SkCubeSat/SNN-Adapter/ethernet-breakout/pcb/footprint_3d/TMJG4820GENL.stp

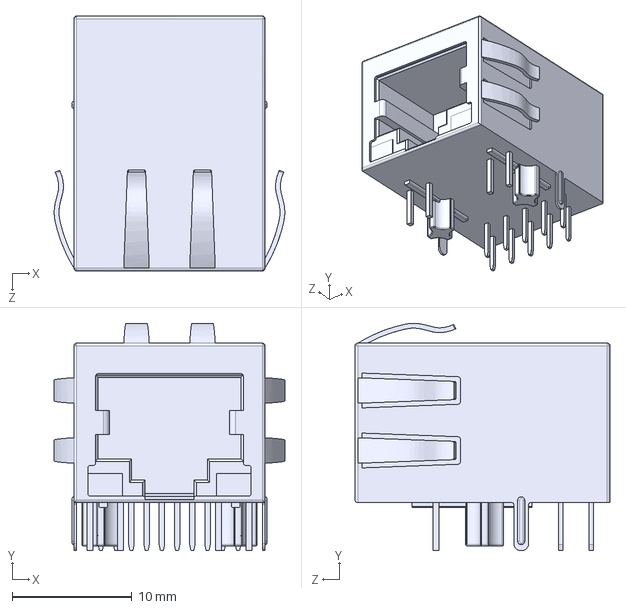
[picture p1: CAD file, 2026-05-10]
ethernet-breakout/pcb/footprint_3d/TMJG4820GENL.stp
19.2 x 18.9 x 21.2 mm
