SkCubeSat/SNN-Adapter/footprint_3d/RTW0024B.stp

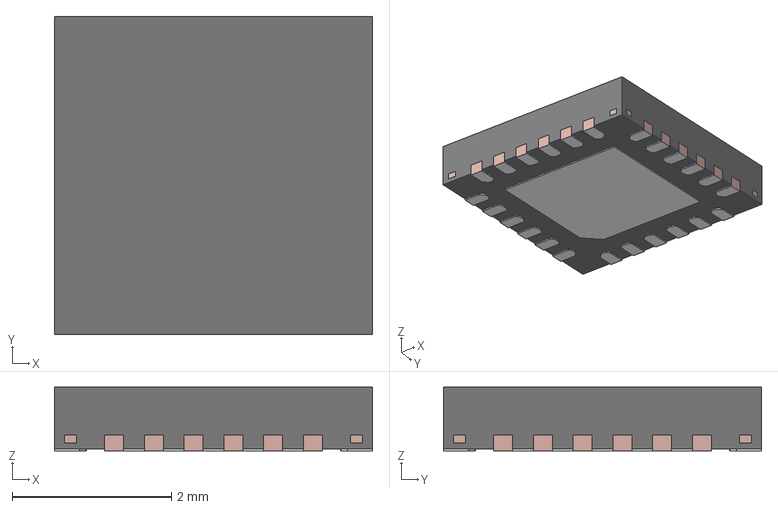
[picture p2: CAD file, 2026-05-04]
footprint_3d/RTW0024B.stp
4.00 x 4.00 x 0.8 mm
FRAME
