SkCubeSat/SNN-Adapter/footprint_3d/DM3BT-DSF-PEJS.stp

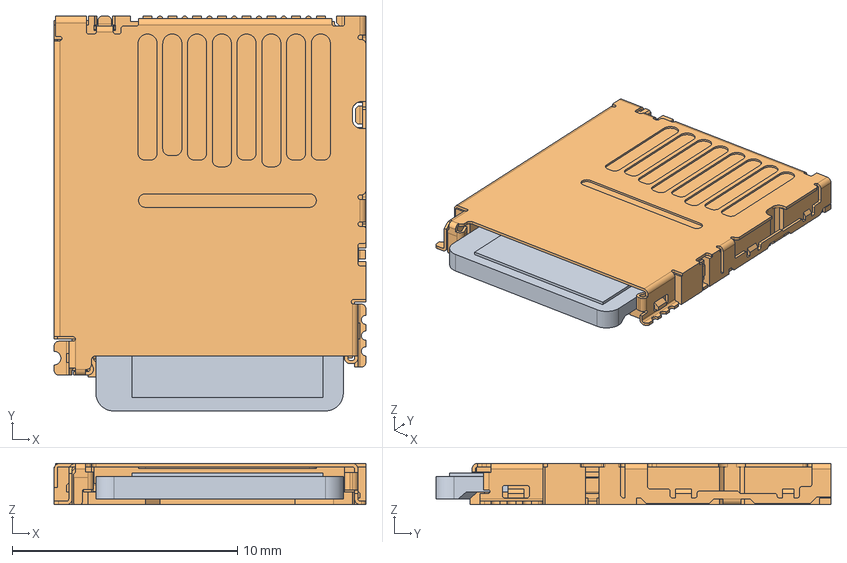
[picture p3: CAD file, 2026-02-09]
footprint_3d/DM3BT-DSF-PEJS.stp
13.8 x 17.5 x 1.83 mm
CARD_1
DM3BT_1
