SkCubeSat/SNN-Adapter/footprint_3d/LTC4300A-1IMS8_PBF.step

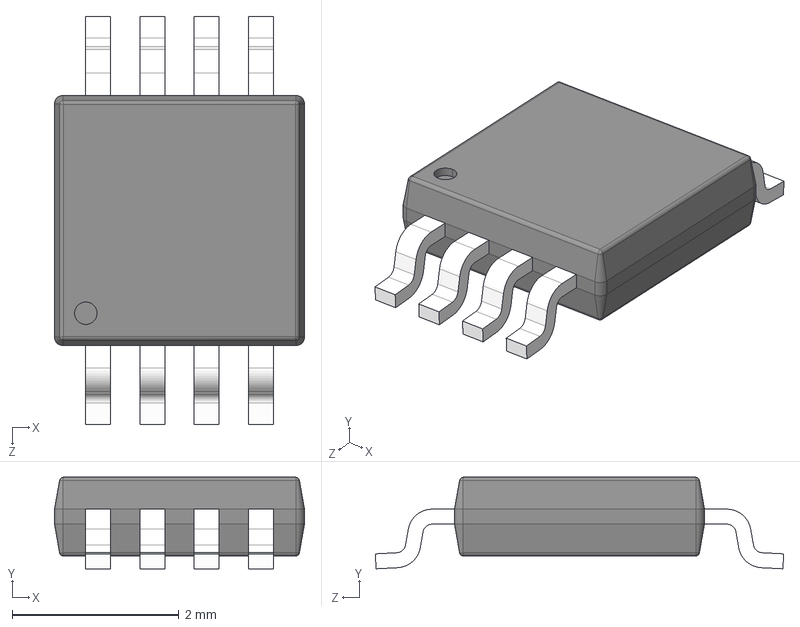
[picture p4: CAD file, 2026-02-09]
footprint_3d/LTC4300A-1IMS8_PBF.step
3.00 x 1.10 x 4.90 mm
