SkCubeSat/SNN-Adapter/footprint_3d/ESQ-126-39-G-D.stp

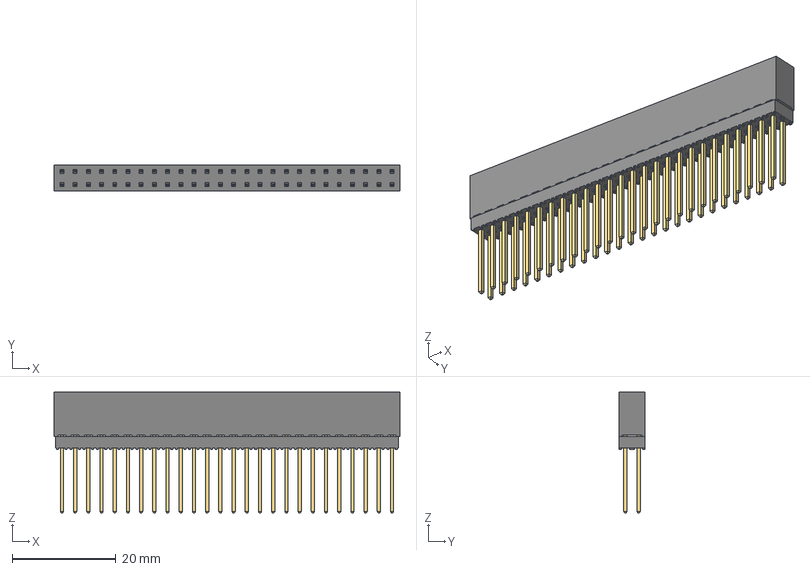
[picture p5: CAD file, 2026-02-09]
footprint_3d/ESQ-126-39-G-D.stp
66.5 x 5.08 x 23.2 mm
ESQ-126-39-G-D_pins
ESQ-126-39-G-D2_pins
ESQ-126-39-G-D-LL_bpins
ESQ-126-39-G-D_socket
