SkCubeSat/SNN-Adapter/footprint_3d/TPS79933QDDCRQ1.step

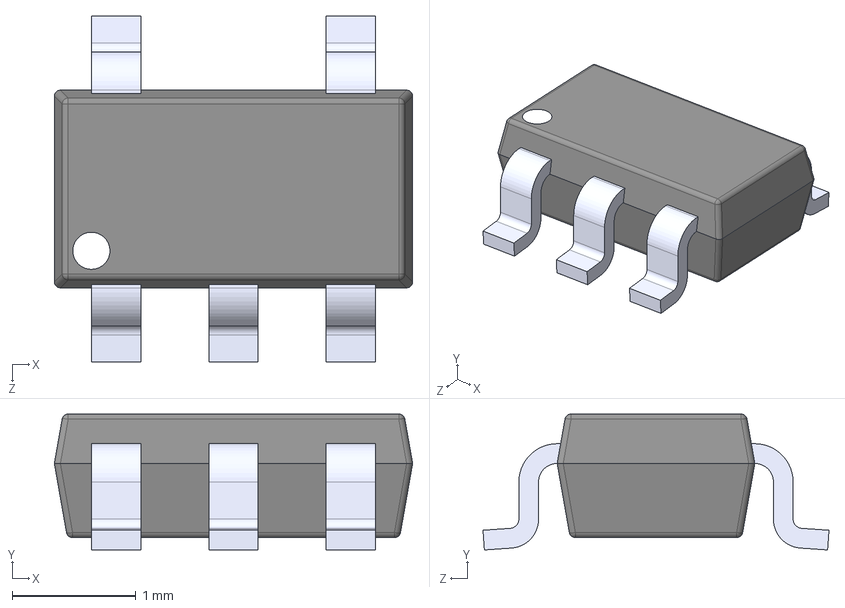
[picture p6: CAD file, 2026-05-30]
footprint_3d/TPS79933QDDCRQ1.step
2.90 x 1.10 x 2.80 mm
