SkCubeSat/SNN-Adapter/adapter-pcb.kicad_pcb

## KiCad design adapter-pcb.kicad_pcb (2026-10-21)

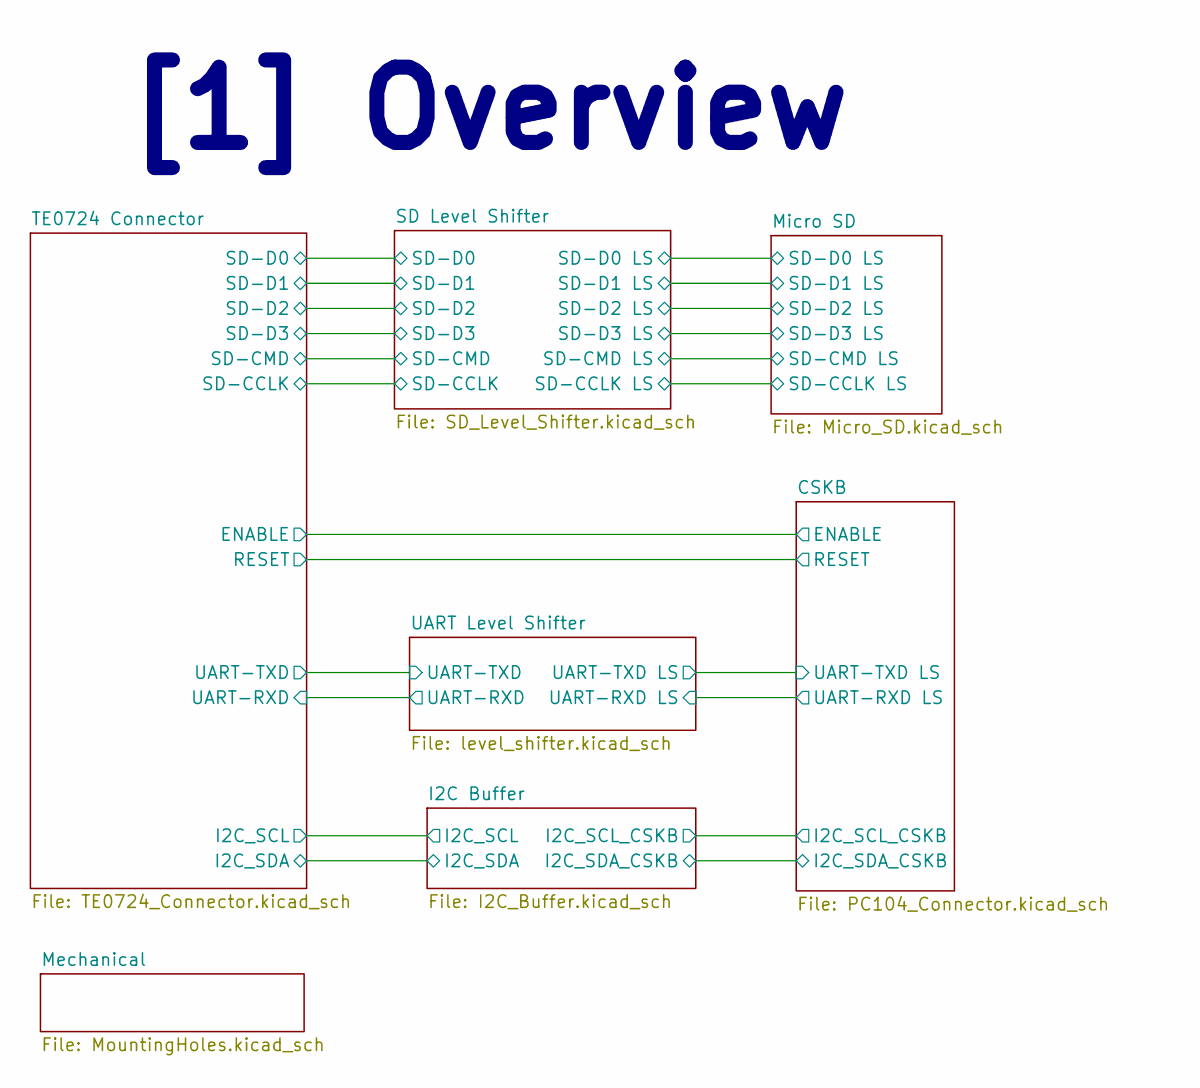
[picture p7: schematic adapter-pcb.kicad_sch, Overview]

Notes on the sheet:
[1] Overview

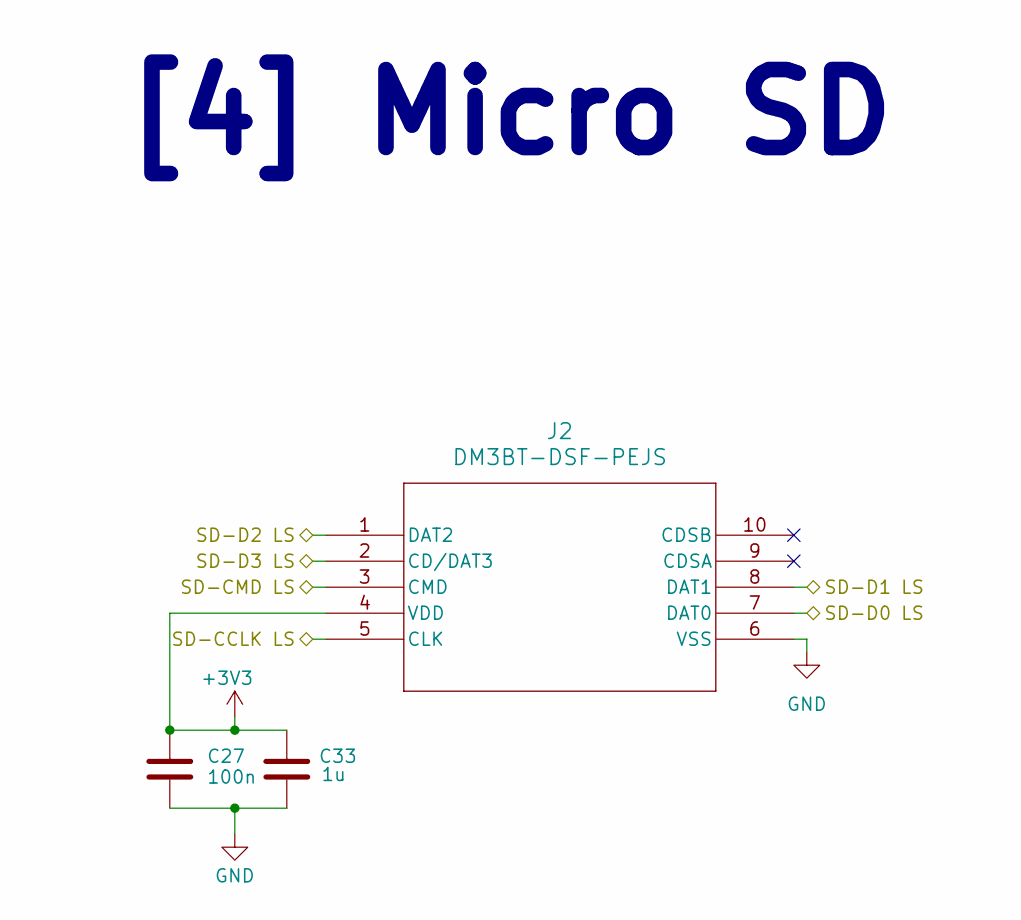
[picture p8: schematic Micro_SD.kicad_sch]

Parts:
C27: 100n; C_0603_1608Metric; MPN GCM188R71H104KA57J
C33: 1u; C_0805_2012Metric; MPN GCM21BR71H105KA03L
J2: DM3BT-DSF-PEJS; DM3BT_DSF_PEJS; MPN DM3BT-DSF-PEJS

Connections:
+3V3: C27.1, C33.1, J2.4 (VDD); also elsewhere on the board
/Micro SD/SD-CCLK LS: J2.5 (CLK); also elsewhere on the board
/Micro SD/SD-CMD LS: J2.3 (CMD); also elsewhere on the board
/Micro SD/SD-D0 LS: J2.7 (DAT0); also elsewhere on the board
/Micro SD/SD-D1 LS: J2.8 (DAT1); also elsewhere on the board
/Micro SD/SD-D2 LS: J2.1 (DAT2); also elsewhere on the board
/Micro SD/SD-D3 LS: J2.2 (CD/DAT3); also elsewhere on the board
GND: C27.2, C33.2, J2.6 (VSS); also elsewhere on the board

Notes on the sheet:
[4] Micro SD

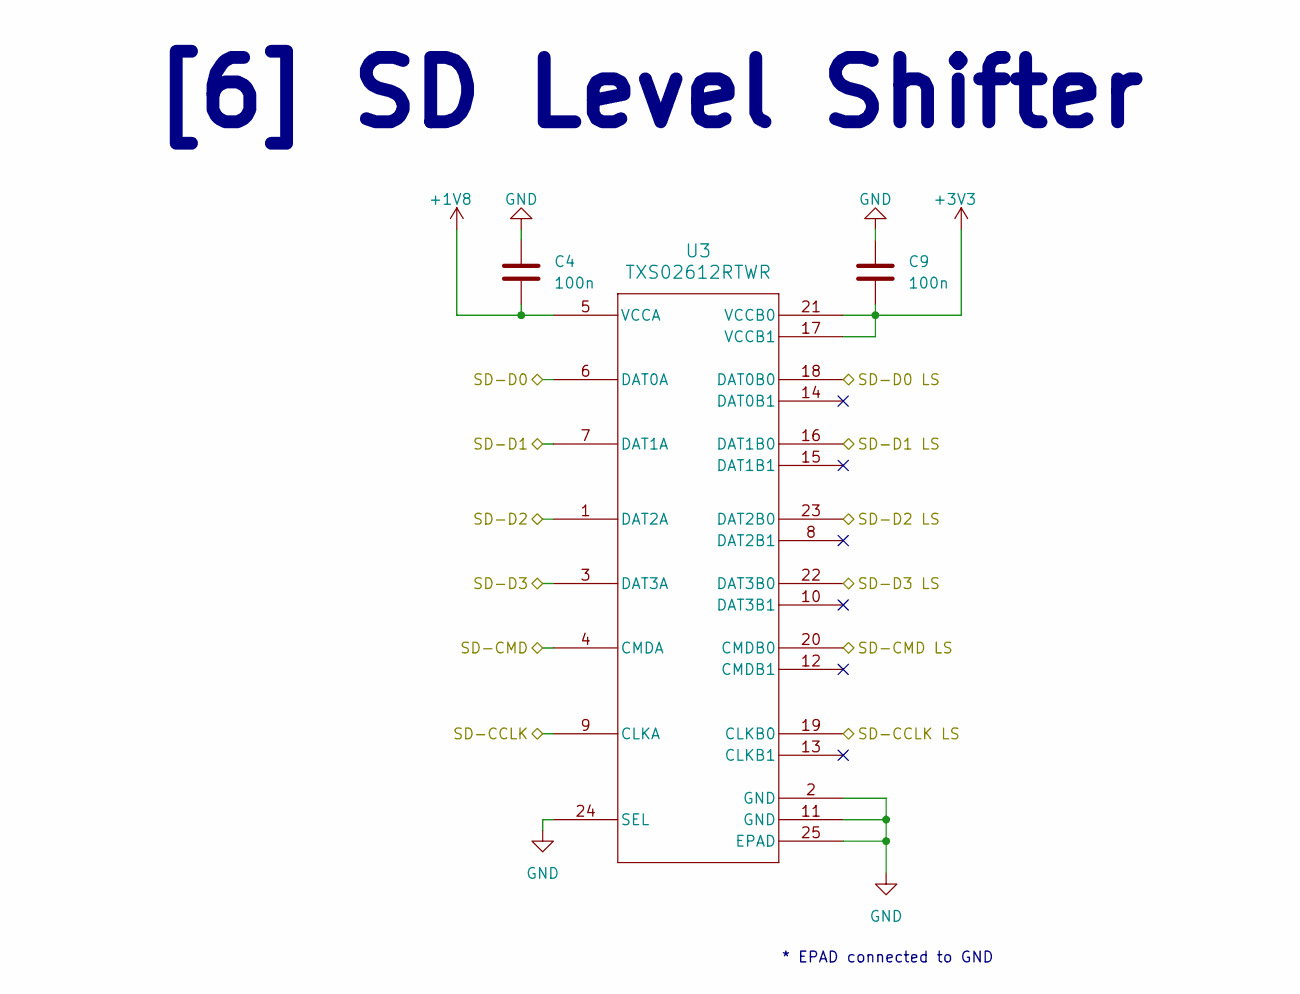
[picture p9: schematic SD_Level_Shifter.kicad_sch]

Parts:
C4, C9: 100n; C_0603_1608Metric; MPN GCM188R71H104KA57J
U3: TXS02612RTWR; RTW24_2P45X2P45; MPN TXS02612RTWR

Connections:
+1V8: C4.2, U3.5 (VCCA); also elsewhere on the board
+3V3: C9.2, U3.17 (VCCB1), U3.21 (VCCB0); also elsewhere on the board
/Micro SD/SD-CCLK LS: U3.19 (CLKB0); also elsewhere on the board
/Micro SD/SD-CMD LS: U3.20 (CMDB0); also elsewhere on the board
/Micro SD/SD-D0 LS: U3.18 (DAT0B0); also elsewhere on the board
/Micro SD/SD-D1 LS: U3.16 (DAT1B0); also elsewhere on the board
/Micro SD/SD-D2 LS: U3.23 (DAT2B0); also elsewhere on the board
/Micro SD/SD-D3 LS: U3.22 (DAT3B0); also elsewhere on the board
/SD Level Shifter/SD-CCLK: U3.9 (CLKA); also elsewhere on the board
/SD Level Shifter/SD-CMD: U3.4 (CMDA); also elsewhere on the board
/SD Level Shifter/SD-D0: U3.6 (DAT0A); also elsewhere on the board
/SD Level Shifter/SD-D1: U3.7 (DAT1A); also elsewhere on the board
/SD Level Shifter/SD-D2: U3.1 (DAT2A); also elsewhere on the board
/SD Level Shifter/SD-D3: U3.3 (DAT3A); also elsewhere on the board
GND: C4.1, C9.1, U3.2 (GND), U3.11 (GND), U3.24 (SEL), U3.25 (EPAD); also elsewhere on the board

Notes on the sheet:
[6] SD Level Shifter
* EPAD connected to GND

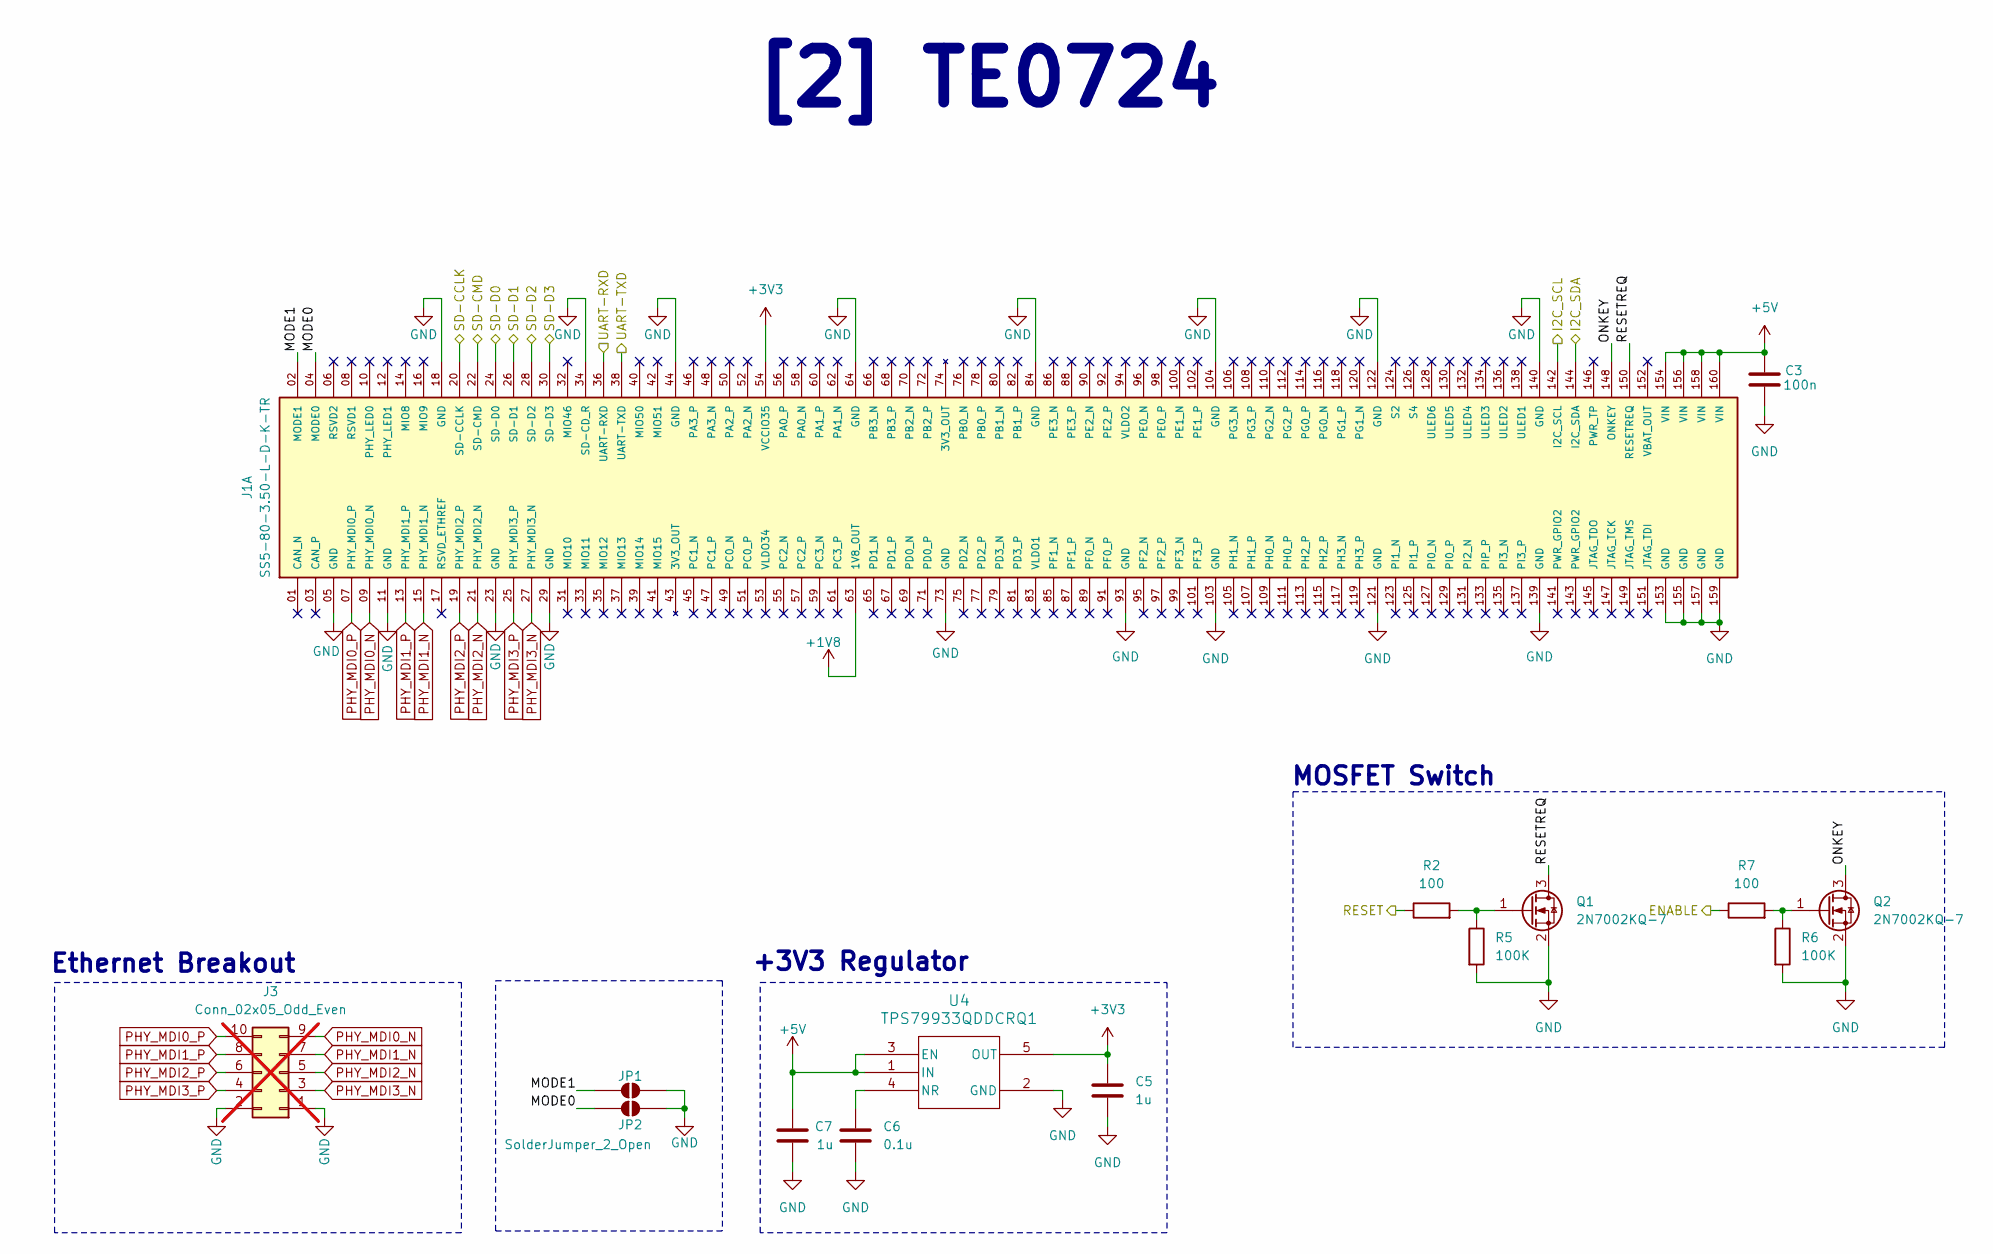
[picture p10: schematic TE0724_Connector.kicad_sch]

Parts:
C3: 100n; C_0603_1608Metric; MPN GCM188R71H104KA57J
C5, C7: 1u; C_1206_3216Metric; MPN GCM31MR71H105KA55L
C6: 0.1u; C_0603_1608Metric; MPN GCM188R71H104KA57J
J1: SS5-80-3.50-L-D-K-TR; SAMTEC_SS5-80-3.50-X-D-K-XX; PARTREV F
J3: Conn_02x05_Odd_Even; PinSocket_2x05_P2.54mm_Vertical; not fitted
JP1, JP2: SolderJumper_2_Open; SolderJumper-2_P1.3mm_Open_RoundedPad1.0x1.5mm
Q1, Q2: 2N7002KQ-7; SOT-23; MPN 2N7002KQ-7
R2, R7: 100; R_0402_1005Metric; MPN MCS0402MD1000BE100
R5, R6: 100K; R_0402_1005Metric; MPN MCS0402MD1003BE100
U4: TPS79933QDDCRQ1; DDC5; MPN TPS79933QDDCRQ1

Connections:
+1V8: J1.63 (1V8_OUT); also elsewhere on the board
+3V3: C5.1, J1.54 (VCCIO35), U4.5 (OUT); also elsewhere on the board
+5V: C3.1, C7.1, J1.154 (VIN), J1.156 (VIN), J1.158 (VIN), J1.160 (VIN), U4.1 (IN), U4.3 (EN); also elsewhere on the board
/CSKB/ENABLE: R7.1; also elsewhere on the board
/CSKB/RESET: R2.1; also elsewhere on the board
/I2C Buffer/I2C_SCL: J1.142 (I2C_SCL); also elsewhere on the board
/I2C Buffer/I2C_SDA: J1.144 (I2C_SDA); also elsewhere on the board
/SD Level Shifter/SD-CCLK: J1.20 (SD-CCLK); also elsewhere on the board
/SD Level Shifter/SD-CMD: J1.22 (SD-CMD); also elsewhere on the board
/SD Level Shifter/SD-D0: J1.24 (SD-D0); also elsewhere on the board
/SD Level Shifter/SD-D1: J1.26 (SD-D1); also elsewhere on the board
/SD Level Shifter/SD-D2: J1.28 (SD-D2); also elsewhere on the board
/SD Level Shifter/SD-D3: J1.30 (SD-D3); also elsewhere on the board
/TE0724 Connector/MODE0: J1.04 (MODE0), JP2.1 (A)
/TE0724 Connector/MODE1: J1.02 (MODE1), JP1.1 (A)
/TE0724 Connector/ONKEY: J1.148 (ONKEY), Q2.3 (D)
/TE0724 Connector/RESETREQ: J1.150 (RESETREQ), Q1.3 (D)
/TE0724 Connector/UART-RXD: J1.36 (UART-RXD); also elsewhere on the board
/TE0724 Connector/UART-TXD: J1.38 (UART-TXD); also elsewhere on the board
GND: C3.2, C5.2, C6.2, C7.2, J1.05 (GND), J1.11 (GND), J1.18 (GND), J1.23 (GND), J1.29 (GND), J1.34 (SD-CD_R), J1.44 (GND), J1.64 (GND), J1.73 (GND), J1.84 (GND), J1.93 (GND), J1.103 (GND), J1.104 (GND), J1.121 (GND), J1.122 (GND), J1.139 (GND), J1.140 (GND), J1.153 (GND), J1.155 (GND), J1.157 (GND), J1.159 (GND), J3.1, J3.2, JP1.2 (B), JP2.2 (B), Q1.2 (S), Q2.2 (S), R5.2, R6.2, U4.2 (GND); also elsewhere on the board
unnamed: Q1.1 (G), R2.2, R5.1
unnamed: Q2.1 (G), R6.1, R7.2
unnamed: C6.1, U4.4 (NR)
PHY_MDI0_N: J1.09 (PHY_MDI0_N), J3.9
PHY_MDI0_P: J1.07 (PHY_MDI0_P), J3.10
PHY_MDI1_N: J1.15 (PHY_MDI1_N), J3.7
PHY_MDI1_P: J1.13 (PHY_MDI1_P), J3.8
PHY_MDI2_N: J1.21 (PHY_MDI2_N), J3.5
PHY_MDI2_P: J1.19 (PHY_MDI2_P), J3.6
PHY_MDI3_N: J1.27 (PHY_MDI3_N), J3.3
PHY_MDI3_P: J1.25 (PHY_MDI3_P), J3.4

Notes on the sheet:
+3V3 Regulator
MOSFET Switch
[2] TE0724
Ethernet Breakout

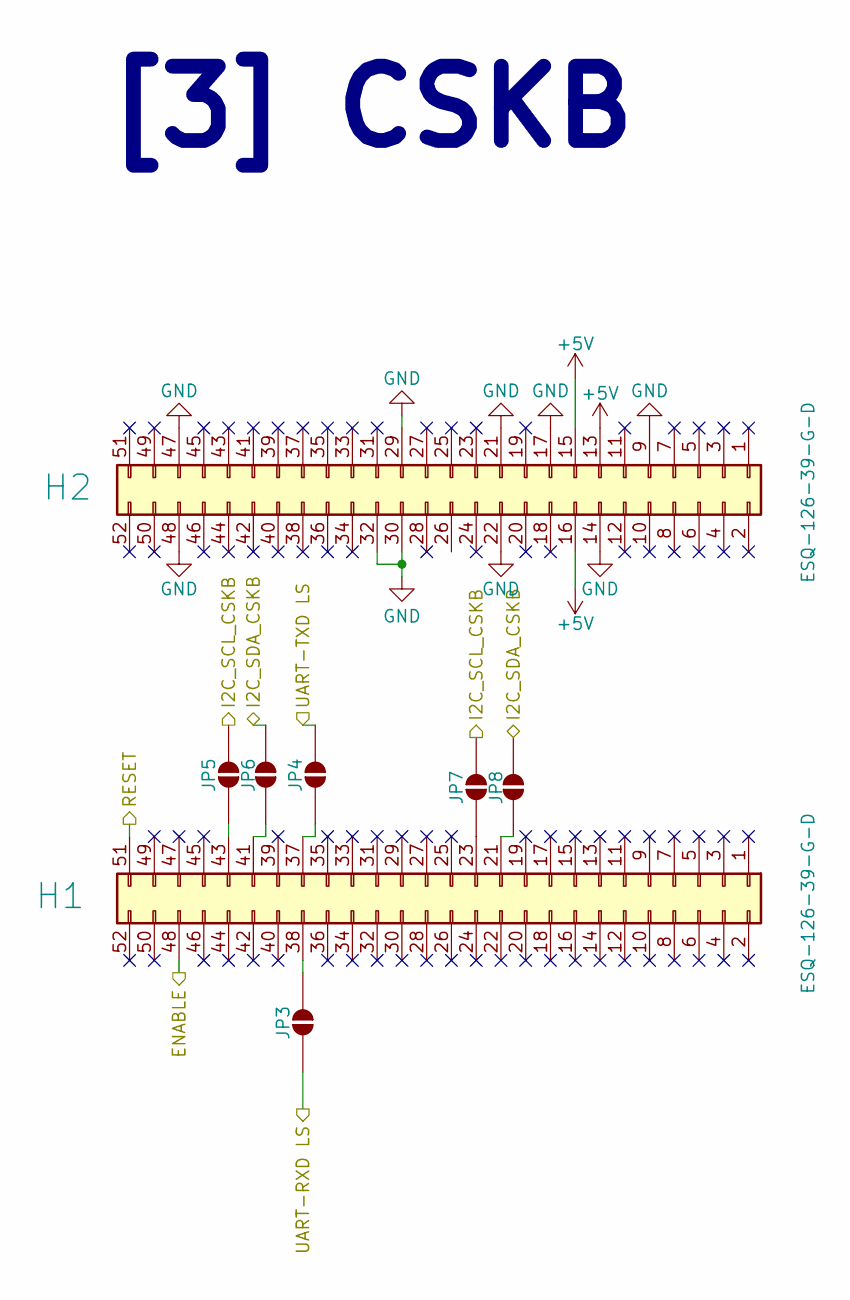
[picture p11: schematic PC104_Connector.kicad_sch]

Parts:
H1, H2: ESQ-126-39-G-D; RHDR52W64P254_2X26_6654X495X1135P; MPN ESQ-126-39-G-D
JP3, JP4: SolderJumper_2_Open; SolderJumper-2_P1.3mm_Bridged_RoundedPad1.0x1.5mm
JP5, JP6, JP7, JP8: SolderJumper_2_Open; SolderJumper-2_P1.3mm_Open_RoundedPad1.0x1.5mm

Connections:
+5V: H2.13, H2.15, H2.16; also elsewhere on the board
/CSKB/ENABLE: H1.48; also elsewhere on the board
/CSKB/I2C_SCL_CSKB: JP5.2 (B), JP7.2 (B); also elsewhere on the board
/CSKB/I2C_SDA_CSKB: JP6.2 (B), JP8.2 (B); also elsewhere on the board
/CSKB/RESET: H1.51; also elsewhere on the board
/CSKB/UART-RXD LS: JP3.1 (A); also elsewhere on the board
/CSKB/UART-TXD LS: JP4.2 (B); also elsewhere on the board
GND: H2.9, H2.14, H2.17, H2.21, H2.22, H2.29, H2.30, H2.32, H2.47, H2.48; also elsewhere on the board
unnamed: H1.21, JP8.1 (A)
unnamed: H1.23, JP7.1 (A)
unnamed: H1.37, JP4.1 (A)
unnamed: H1.38, JP3.2 (B)
unnamed: H1.41, JP6.1 (A)
unnamed: H1.43, JP5.1 (A)

Notes on the sheet:
[3] CSKB

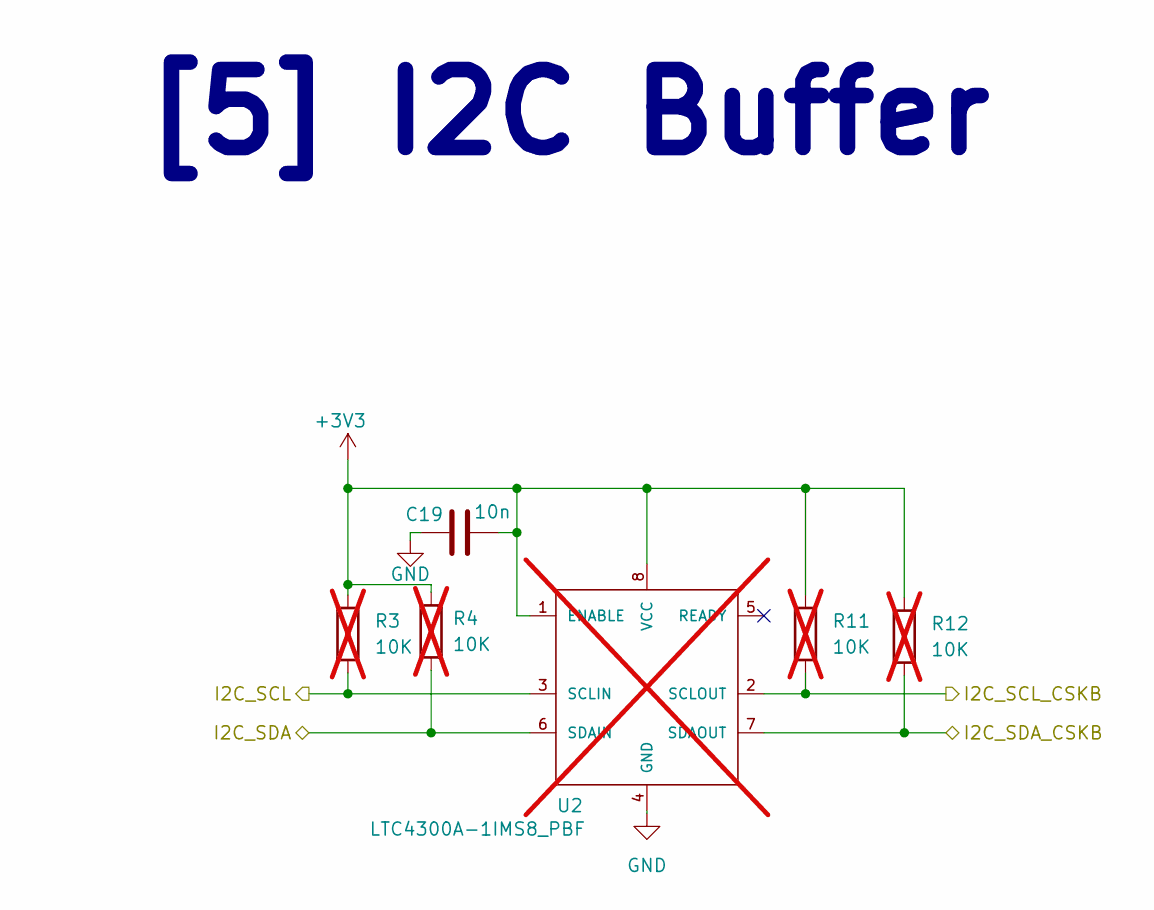
[picture p12: schematic I2C_Buffer.kicad_sch]

Parts:
C19: 10n; C_0402_1005Metric; MPN GCM155R71H103KA55J
R3, R4, R11, R12: 10K; R_0402_1005Metric; MPN MCS0402MD1002BE100; not fitted
U2: LTC4300A-1IMS8_PBF; MPN ltc4300a1ims8; not fitted

Connections:
+3V3: C19.2, R3.1, R4.1, R11.1, R12.1, U2.1 (ENABLE), U2.8 (VCC); also elsewhere on the board
/CSKB/I2C_SCL_CSKB: R11.2, U2.2 (SCLOUT); also elsewhere on the board
/CSKB/I2C_SDA_CSKB: R12.2, U2.7 (SDAOUT); also elsewhere on the board
/I2C Buffer/I2C_SCL: R3.2, U2.3 (SCLIN); also elsewhere on the board
/I2C Buffer/I2C_SDA: R4.2, U2.6 (SDAIN); also elsewhere on the board
GND: C19.1, U2.4 (GND); also elsewhere on the board

Notes on the sheet:
[5] I2C Buffer

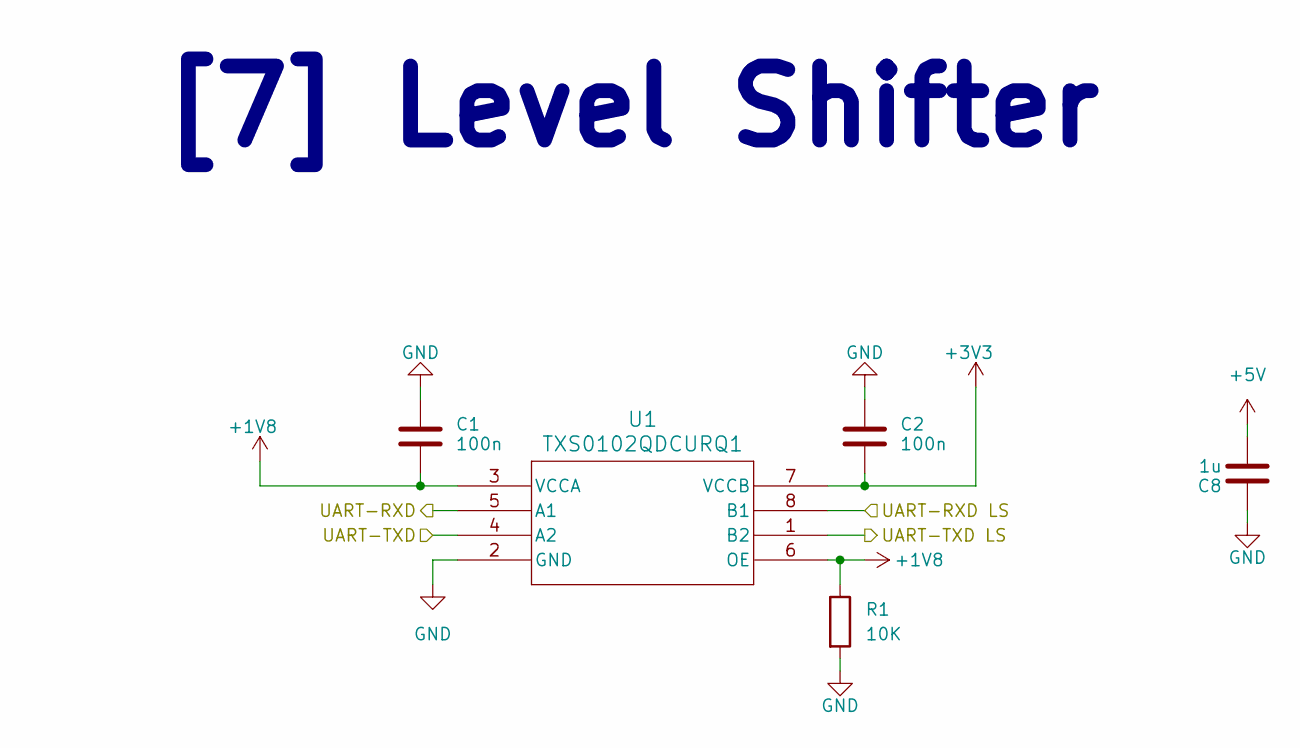
[picture p13: schematic level_shifter.kicad_sch]

Parts:
C1, C2: 100n; C_0603_1608Metric; MPN GCM188R71H104KA57J
C8: 1u; C_0603_1608Metric; MPN GCM188R71E105KA64D
R1: 10K; R_0402_1005Metric; MPN MCS0402MD1002BE100
U1: TXS0102QDCURQ1; MPN TXS0102QDCURQ1

Connections:
+1V8: C1.2, R1.1, U1.3 (VCCA), U1.6 (OE); also elsewhere on the board
+3V3: C2.2, U1.7 (VCCB); also elsewhere on the board
+5V: C8.2; also elsewhere on the board
/CSKB/UART-RXD LS: U1.8 (B1); also elsewhere on the board
/CSKB/UART-TXD LS: U1.1 (B2); also elsewhere on the board
/TE0724 Connector/UART-RXD: U1.5 (A1); also elsewhere on the board
/TE0724 Connector/UART-TXD: U1.4 (A2); also elsewhere on the board
GND: C1.1, C2.1, C8.1, R1.2, U1.2 (GND); also elsewhere on the board

Notes on the sheet:
[7] Level Shifter

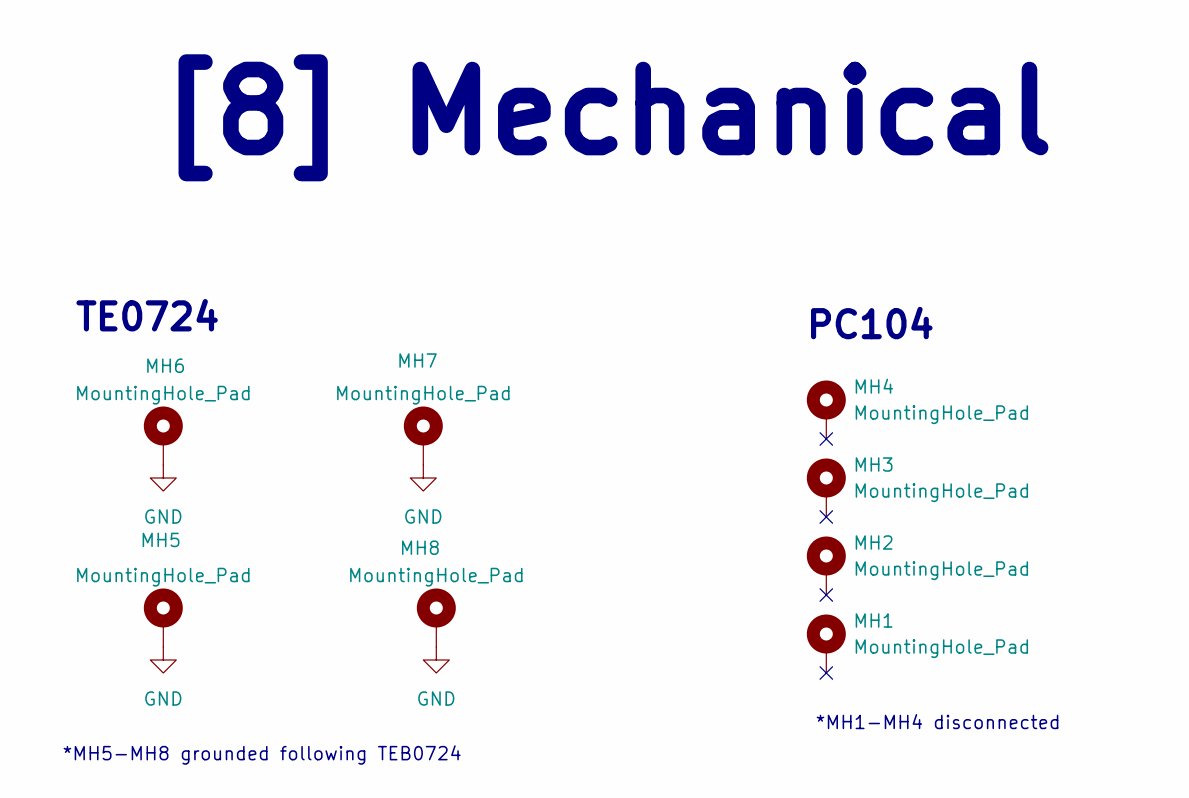
[picture p14: schematic MountingHoles.kicad_sch]

Parts:
MH1, MH2, MH3, MH4: MountingHole_Pad; MountingHole_3.18mm_6.35mm_Pad
MH5, MH6, MH7, MH8: MountingHole_Pad; MountingHole_2.2mm_M2_Pad

Connections:
GND: MH5.1 (1_1), MH6.1 (1_1), MH7.1 (1_1), MH8.1 (1_1); also elsewhere on the board

Notes on the sheet:
PC104
*MH1-MH4 disconnected
[8] Mechanical
TE0724
*MH5-MH8 grounded following TEB0724

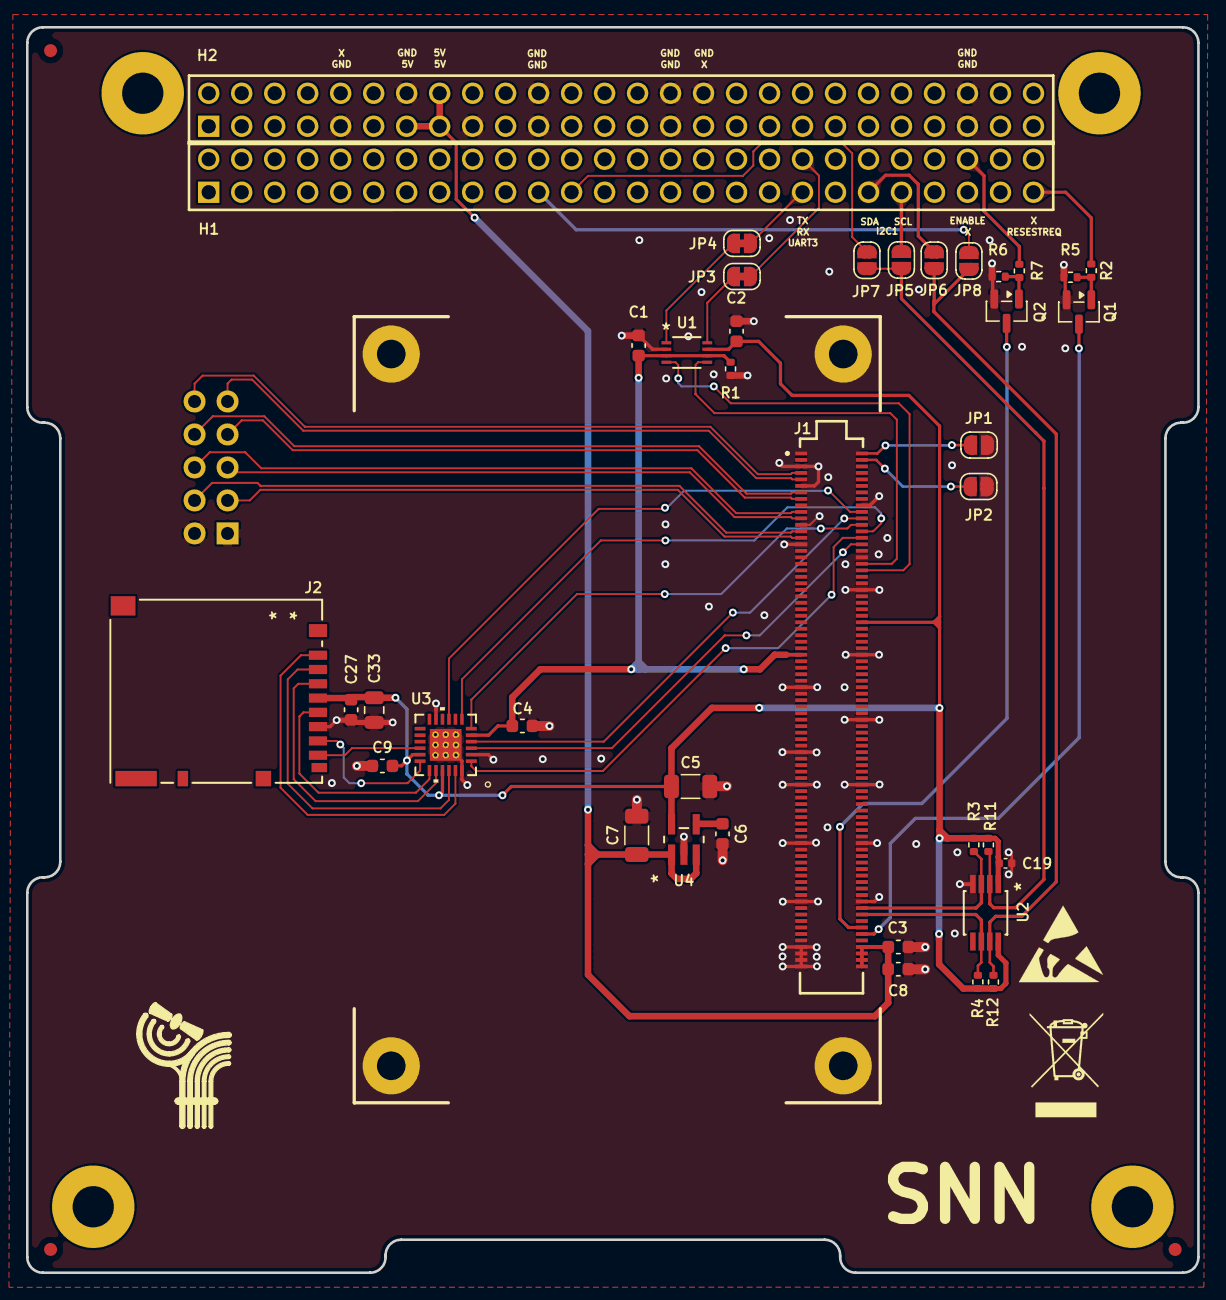
[picture p15: board adapter-pcb.kicad_pcb from above]

Board: 2 copper layers, 90.2 x 95.9 mm, 48 parts (1 on the bottom side), 47 nets.
