SkCubeSat/SNN-Adapter/ethernet-breakout/pcb/Ethernet-Breakout.kicad_pcb

## KiCad design ethernet-breakout/pcb/Ethernet-Breakout.kicad_pcb (2026-05-10)

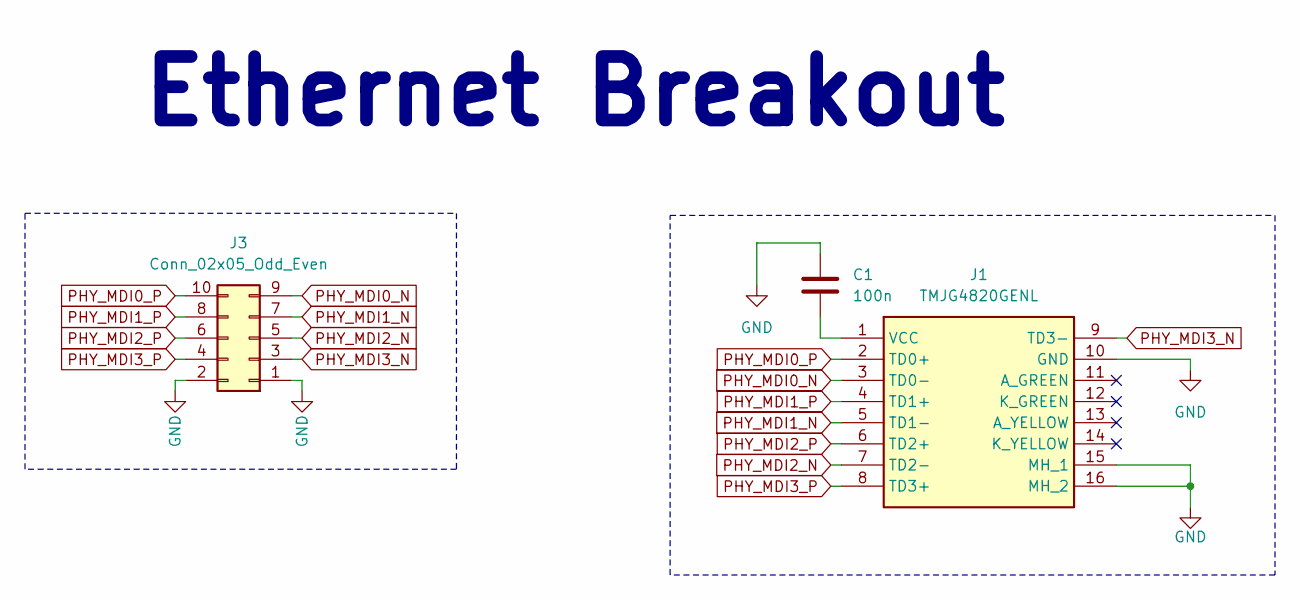
[picture p16: schematic Ethernet-Breakout.kicad_sch]

Parts:
C1: 100n; C_Disc_D3.0mm_W1.6mm_P2.50mm
J1: TMJG4820GENL; Mouser Part Number 960-TMJG4820GENL
J3: Conn_02x05_Odd_Even; PinSocket_2x05_P2.54mm_Vertical

Connections:
GND: C1.1, J1.10 (GND), J1.15 (MH_1), J1.16 (MH_2), J3.1, J3.2
unnamed: C1.2, J1.1 (VCC)
PHY_MDI0_N: J1.3 (TD0-), J3.9
PHY_MDI0_P: J1.2 (TD0+), J3.10
PHY_MDI1_N: J1.5 (TD1-), J3.7
PHY_MDI1_P: J1.4 (TD1+), J3.8
PHY_MDI2_N: J1.7 (TD2-), J3.5
PHY_MDI2_P: J1.6 (TD2+), J3.6
PHY_MDI3_N: J1.9 (TD3-), J3.3
PHY_MDI3_P: J1.8 (TD3+), J3.4

Notes on the sheet:
Ethernet Breakout

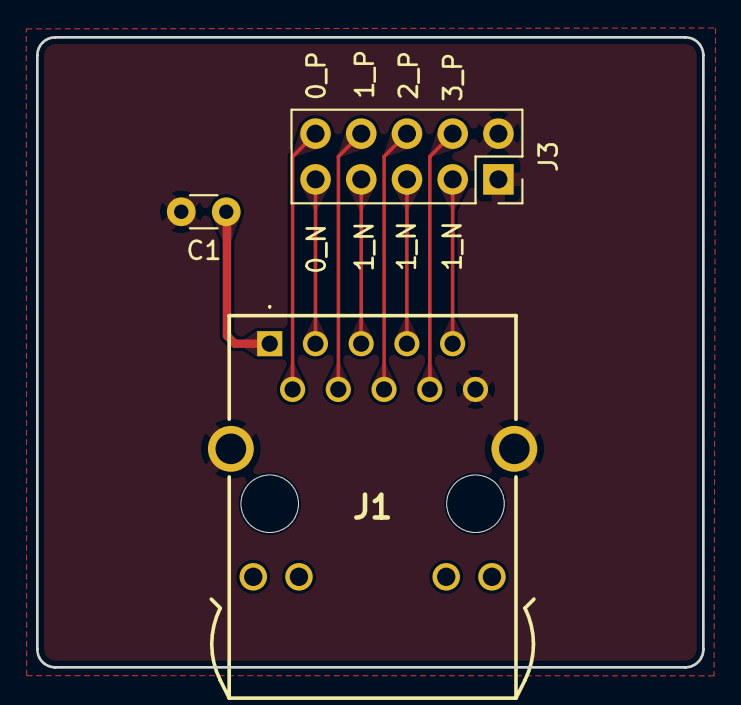
[picture p17: board Ethernet-Breakout.kicad_pcb from above]

Board: 2 copper layers, 37.0 x 35.0 mm, 3 parts (0 on the bottom side), 10 nets.
