SkCubeSat/SNN-Adapter/(commit log)

2026-02-08 Routed PCB (with I2C buffer)
    [I2C_Buffer.kicad_sch, Micro_SD.kicad_sch, MountingHoles.kicad_sch, PC104_Connector.kicad_sch, TE0724_Connector.kicad_sch, adapter-pcb.kicad_pcb, adapter-pcb.kicad_sch]
2026-02-09 fixed and labeled CSKB header, added 3D models
    [DM3BT-DSF-PEJS.stp, ESQ-126-39-G-D.stp, LTC4300A-1IMS8_PBF.step, PC104_Connector.kicad_sch, adapter-pcb.kicad_pcb]
2026-02-15 Fixed GND issues with connector and mounting holes
    [I2C_Buffer.kicad_sch, Micro_SD.kicad_sch, MountingHoles.kicad_sch, PC104_Connector.kicad_sch, TE0724_Connector.kicad_sch, adapter-pcb.kicad_pcb, adapter-pcb.kicad_sch]
2026-05-02 Added some decoup caps and reviewed PCB layout
    [I2C_Buffer.kicad_sch, Micro_SD.kicad_sch, MountingHoles.kicad_sch, PC104_Connector.kicad_sch, TE0724_Connector.kicad_sch, adapter-pcb.kicad_pcb, adapter-pcb.kicad_sch, level_shifter.kicad_sch]
2026-05-03 removed some decoup caps because I added to many haha
    [TE0724_Connector.kicad_sch, adapter-pcb.kicad_pcb, level_shifter.kicad_sch]
2026-05-04 Added Level Shifter for SD card
    [I2C_Buffer.kicad_sch, Micro_SD.kicad_sch, MountingHoles.kicad_sch, PC104_Connector.kicad_sch, RTW0024B.stp, SD_Level_Shifter.kicad_sch, TE0724_Connector.kicad_sch, adapter-pcb.kicad_pcb]
2026-05-05 Rerouted SD a little bit
    [adapter-pcb.kicad_pcb]
2026-05-05 Rerouted 3V3 trace
    [SD_Level_Shifter.kicad_sch, adapter-pcb.kicad_pcb]
2026-05-07 moved vias farther from pads
    [adapter-pcb.kicad_pcb]
2026-05-10 Added pcb files for ethernet breakout board
    [Ethernet-Breakout.kicad_pcb, Ethernet-Breakout.kicad_sch, I2C_Buffer.kicad_sch, Micro_SD.kicad_sch, MountingHoles.kicad_sch, PC104_Connector.kicad_sch, SD_Level_Shifter.kicad_sch, TE0724_Connector.kicad_sch]
2026-05-17 Updated BOM and added fiducials
    [I2C_Buffer.kicad_sch, Micro_SD.kicad_sch, PC104_Connector.kicad_sch, SD_Level_Shifter.kicad_sch, TE0724_Connector.kicad_sch, adapter-pcb.kicad_pcb, level_shifter.kicad_sch]
2026-05-30 Changed connector orientation and power changes
    [PC104_Connector.kicad_sch, TE0724_Connector.kicad_sch, TPS79933QDDCRQ1.step, adapter-pcb.kicad_pcb, adapter-pcb.kicad_sch, level_shifter.kicad_sch]
2026-05-30 reviewed changes to PCB
    [adapter-pcb.kicad_pcb]
2026-05-31 added mroe GND pins and moved power to PDM lines
    [PC104_Connector.kicad_sch, adapter-pcb.kicad_pcb]
2026-05-31 Made very tiny tweaks
    [adapter-pcb.kicad_pcb, level_shifter.kicad_sch]
2026-05-31 Made very tiny tweaks again
    [TE0724_Connector.kicad_sch, adapter-pcb.kicad_pcb]
2026-06-03 added solder bridges and updated BOM
    [I2C_Buffer.kicad_sch, Micro_SD.kicad_sch, MountingHoles.kicad_sch, PC104_Connector.kicad_sch, SD_Level_Shifter.kicad_sch, TE0724_Connector.kicad_sch, adapter-pcb.kicad_pcb, level_shifter.kicad_sch]
2026-10-18 Reversed RX and TX pins to accommodate altered UART standard
2026-10-20 updated pinout on the silkscreen
2026-10-21 updated gerber files
